Klajdi00/LibreRover/docs/Arduino-Robo-Workhop.pdf

Dennis Buchberger – 25.04.2026 | 1

## AKADEMIE DANACH 2026

# ROBOTERPROGRAMMIERUNG MIT ARDUINO

# WIR BAUEN EINEN ROBO

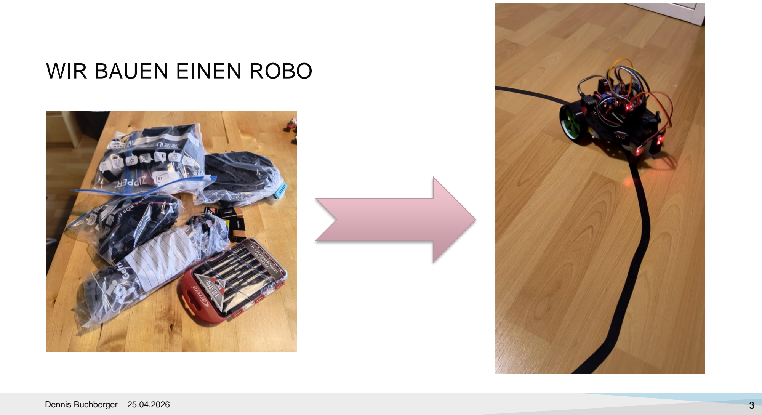
[picture p2: page 3]

# BAUTEILE: MIKROPROZESSOR

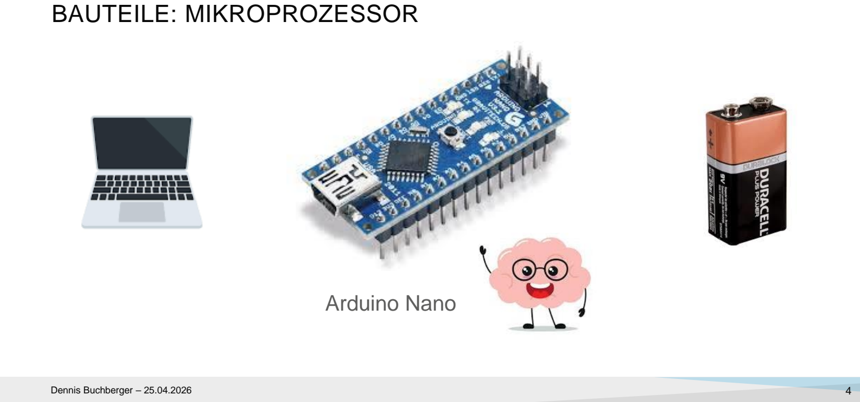
[picture p3: page 4]

# Arduino Nano

# BAUTEILE: SENSOREN

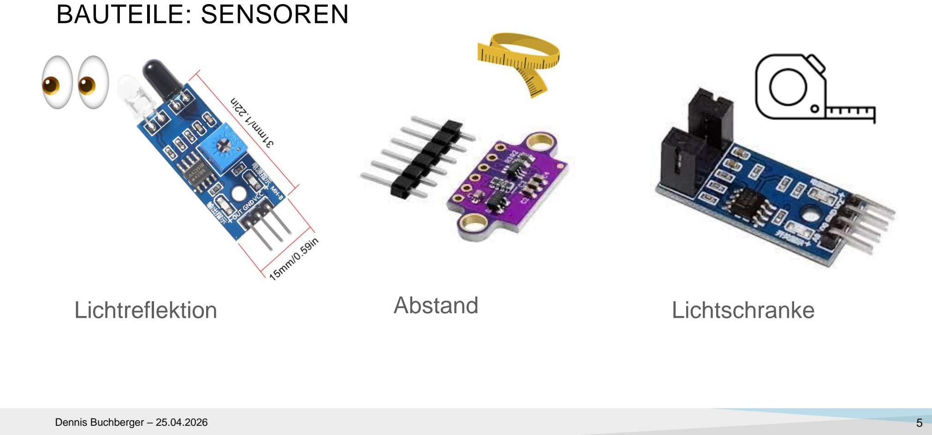
[picture p4: page 5]

Lichtreflektion | Abstand | Lichtschranke

# BAUTEILE: MOTOREN

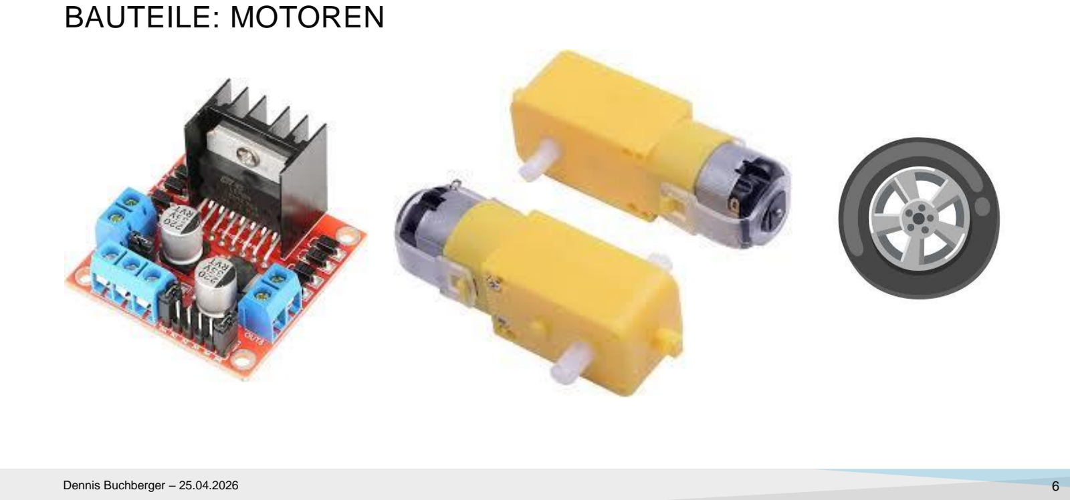
[picture p5: page 6]

# BREAKOUT-BOARD

# Pins

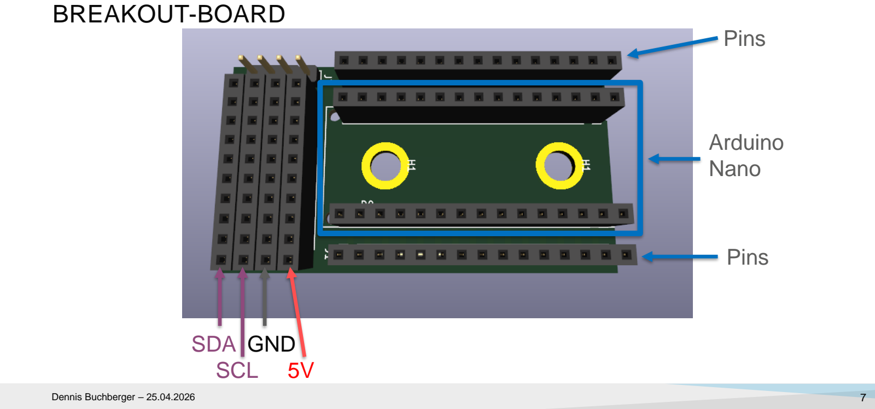
[picture p6: page 7]

# SDA GND SCL 5V

# Arduino Nano

# Pins

# WIE BEWEGT SICH DER MOTOR?

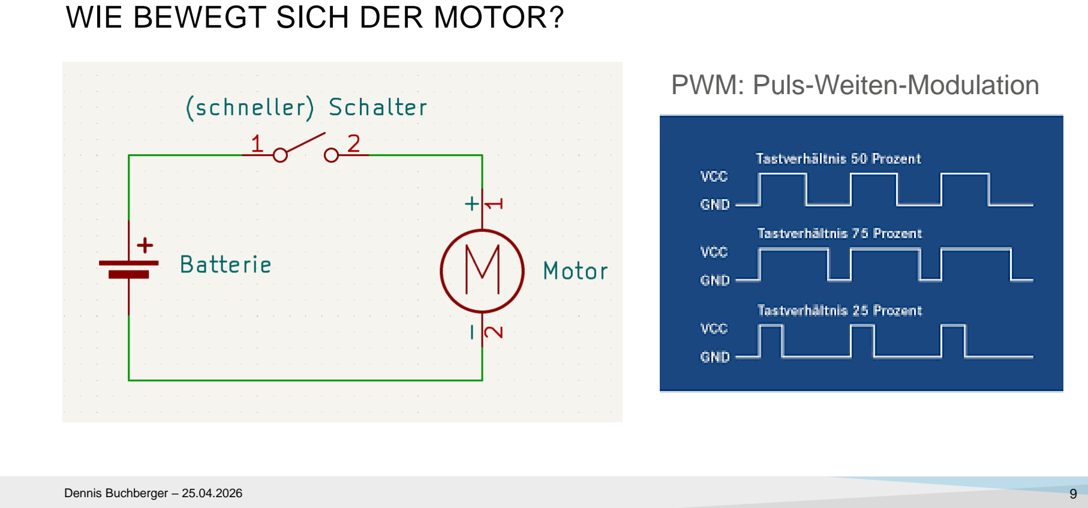
[picture p7: page 9]

# PWM: Puls-Weiten-Modulation

# MOTOR-TREIBER

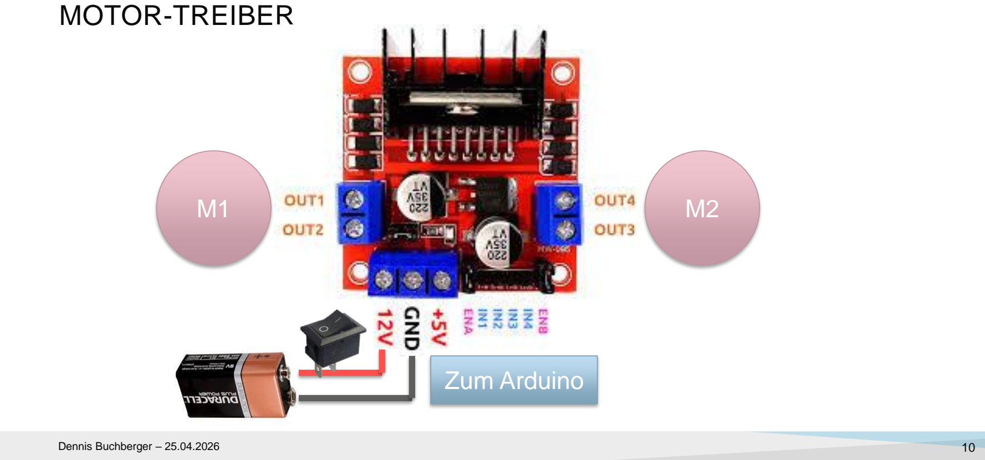
[picture p8: page 10]

M1 | M2

# Zum Arduino

# WIE FUNKTIONIEREN DIE LICHTSENSOREN?

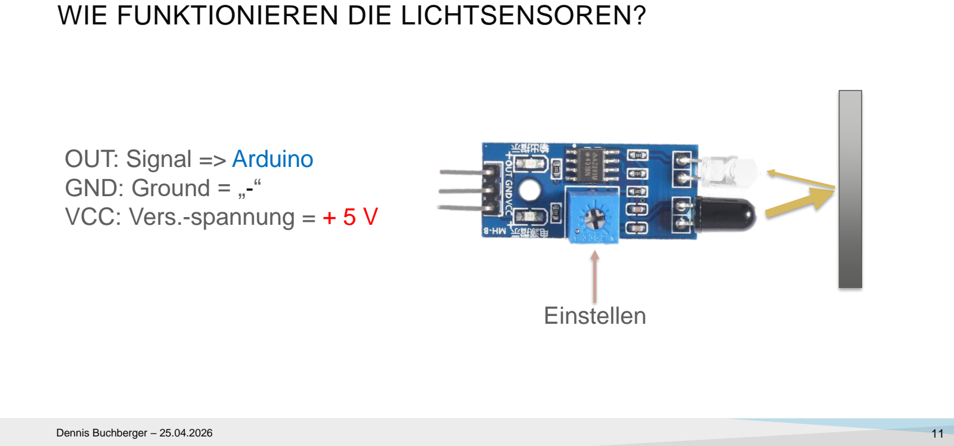
[picture p9: page 11]

# OUT: Signal => Arduino GND: Ground = „-“ VCC: Vers.-spannung = + 5 V

# Einstellen

# WIE FUNKTIONIEREN DIE ABSTANDSSENSOREN?

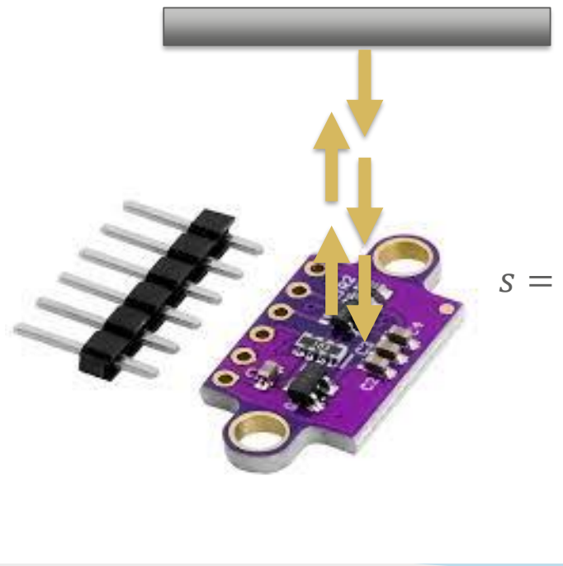
[picture p10: figure]

# GND: Ground = „-“ VCC: Vers.-spannung = + 5 V SCL: Serial Clock => I2C SDA: Serial Data => I2C XSHUT: Soft-Shutdown

Δt
c

I

# 2C: INTER-INTEGRATED-CIRCUIT BUS

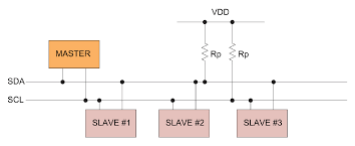
[picture p11: figure]

# Master: Steuert alles - Gibt Takt an (SCL) - Sendet Daten (SDA)

- Erlaubt den anderen,

# zu senden

# ARDUINO NANO: PINOUT

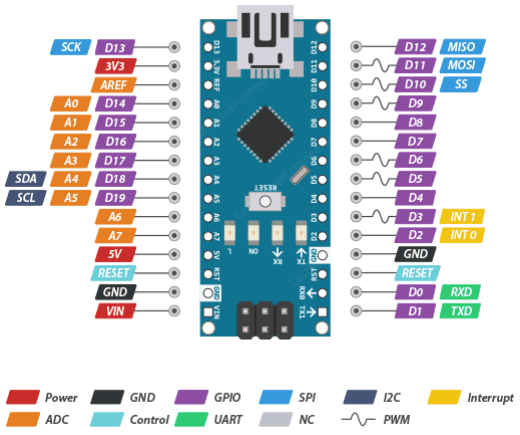
[picture p12: figure]
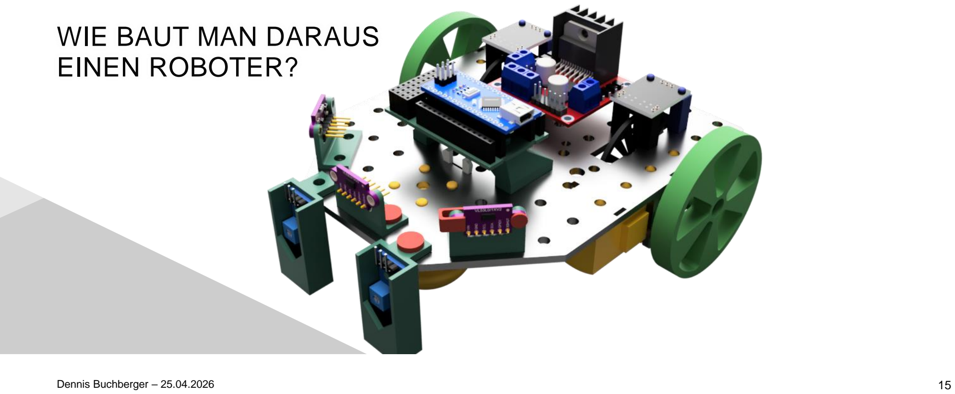
[picture p13: page 15]

# WIE BAUT MAN DARAUS EINEN ROBOTER?

# BODENPLATTE UND MOTOREN

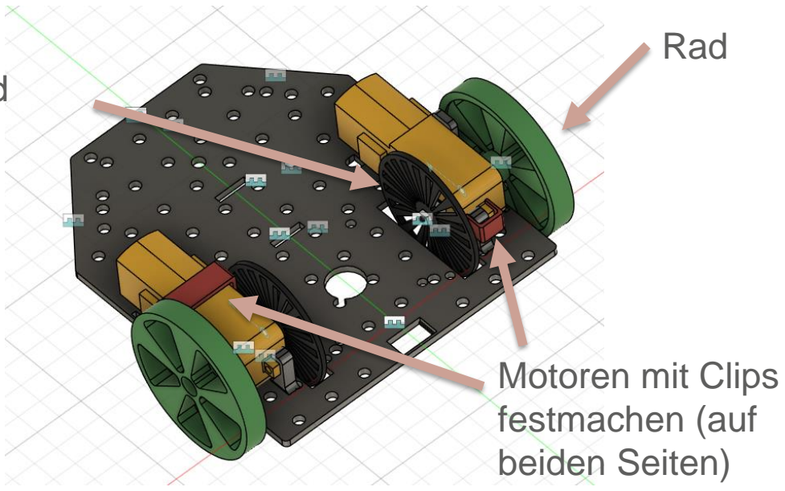
[picture p14: figure]
Motoren mit Clips festmachen (auf beiden Seiten); Rad

# Encoderrad (später)

# BATTERIE

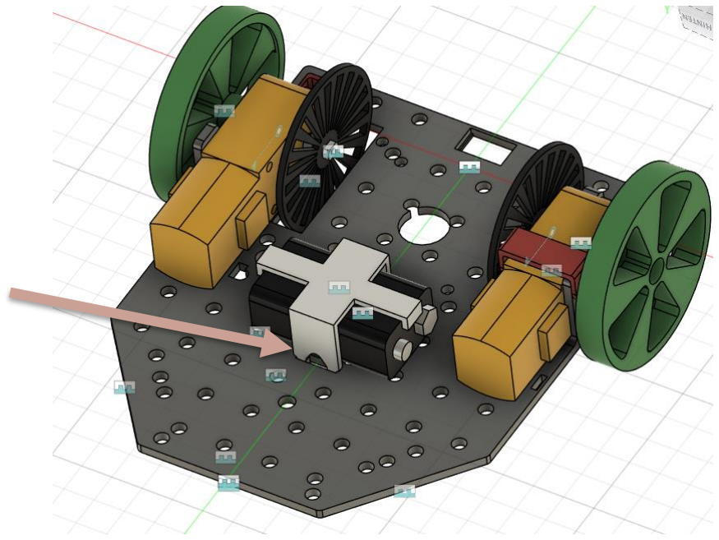
[picture p15: figure]

# Vorsichtig in die Schlitze drücken

# GLEITER („DRITTES RAD“)

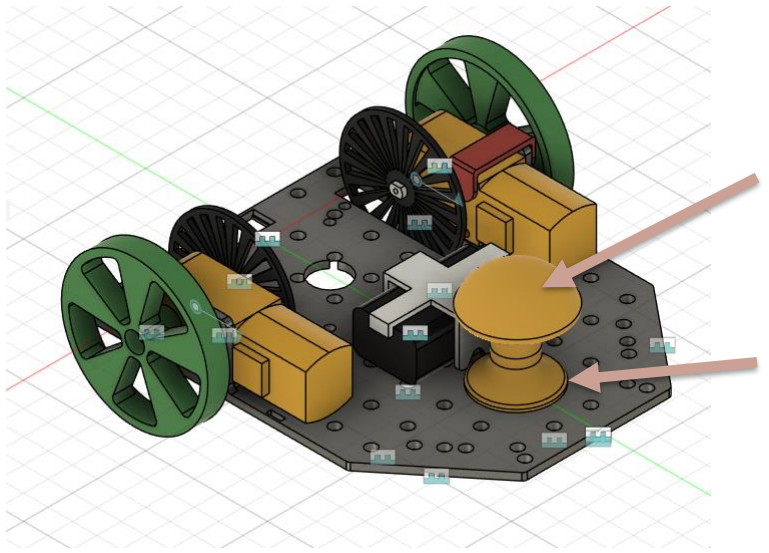
[picture p16: figure]

# Vorsichtig in die Löcher drücken

# Halben Tischtennisball darauf kleben

# MOTORTREIBER

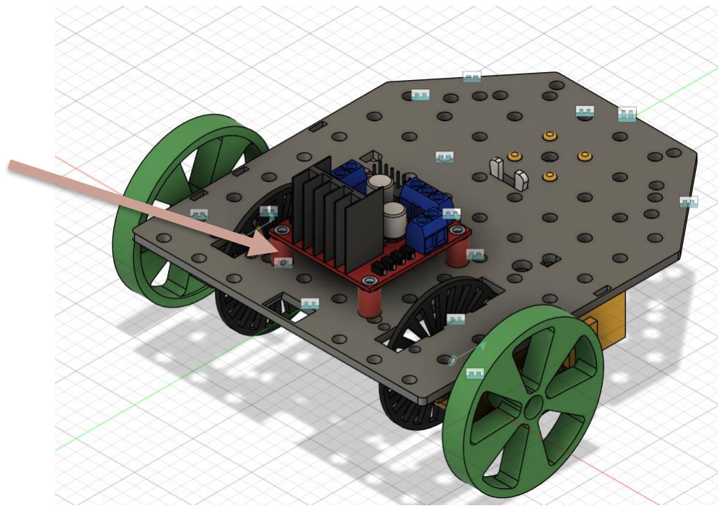
[picture p17: figure]

# Mit Abstandshaltern festschrauben

# ARDUINO

# Platine + Arduino Nano

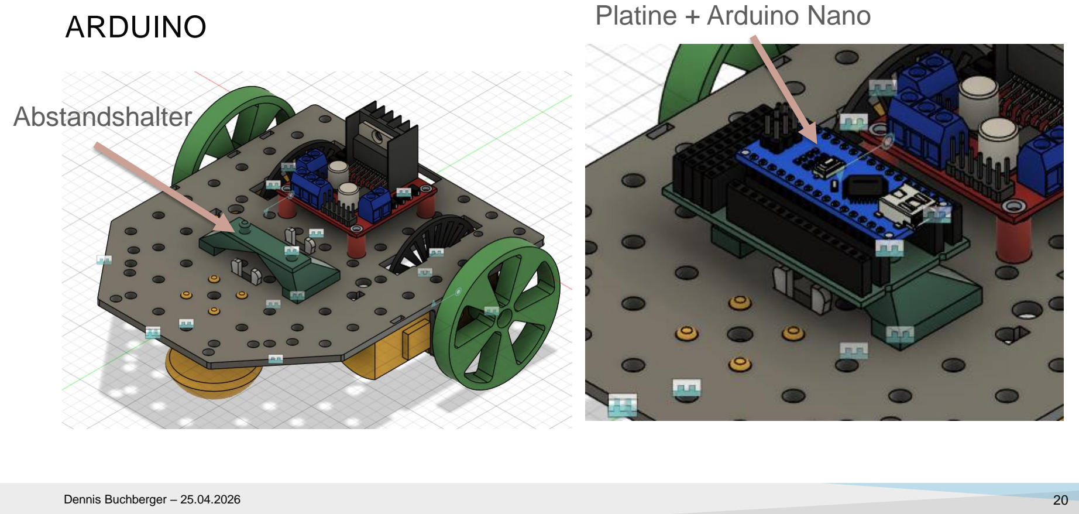
[picture p18: page 20]

# Abstandshalter

# LICHTSENSOREN

# Beide Sensoren mit Plastik-Pin vorsichtig festdrücken

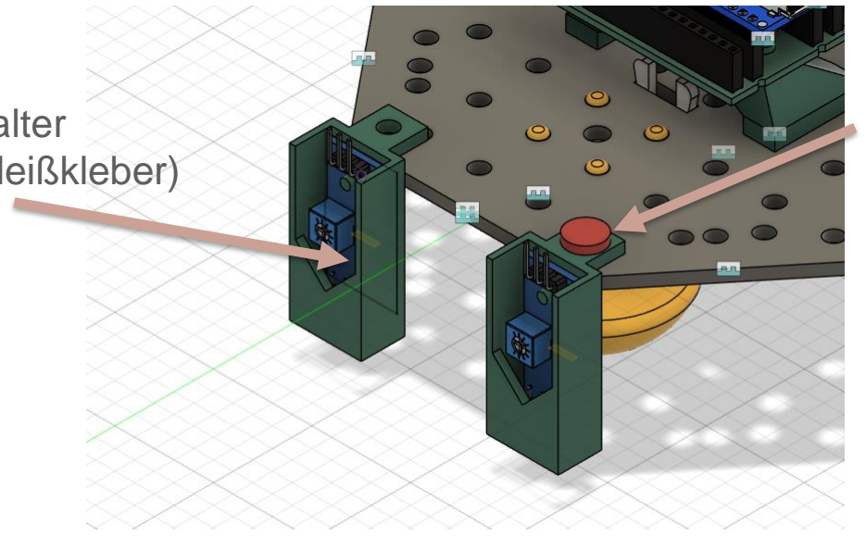
[picture p19: figure]

# Sensor in Halter einkleben (Heißkleber)

# MOTOR-ENCODER

# Vorsichtig

festdrücken,
eventuell kleben.

# Pfeilrichtung beachten

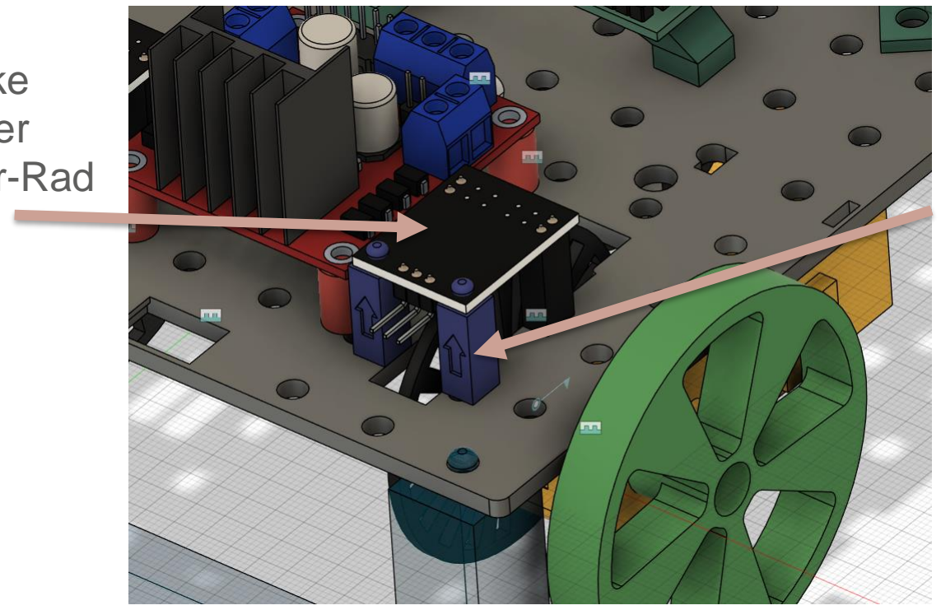
[picture p20: figure]

# Lichtschranke kopfüber über das Encoder-Rad

# ANSCHLÜSSE

# Motor-Treiber: - 12V: Schalter – Batterie

- 5V:

# - Arduino 5V - I2C 5V

# - GND: Alle GND zusammen - Motoren: Links und Rechts an „Out“

# - ENA => Arduino 11

# - 1, 2 => Arduino 9, 10 - 3, 4 => Arduino 7, 8

# - ENB => Arduino 6

# Reflektionssensor: - VCC => 5V (Vom I2C) - GND => GND (vom I2C)

# - Out => Arduino

# - Links: Pin 4

# - Rechts: Pin 5

# ANSCHLÜSSE

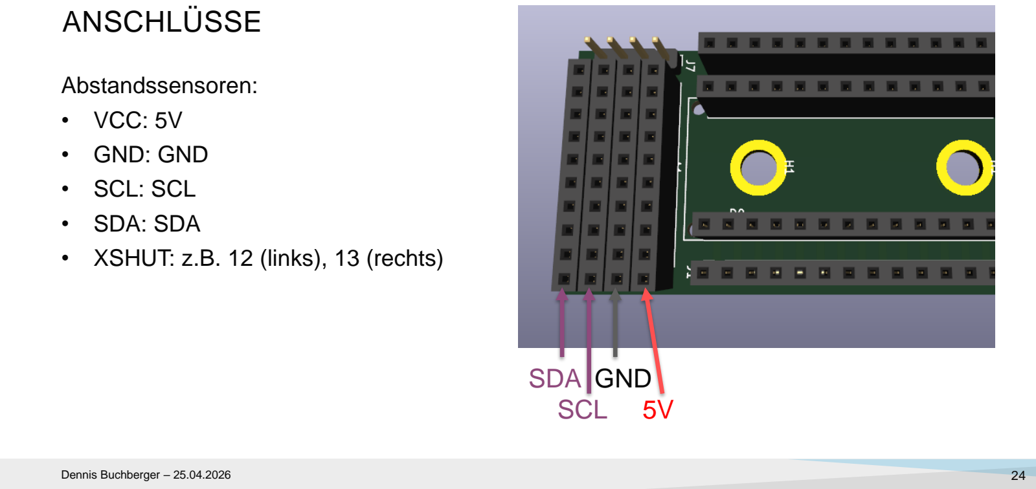
[picture p21: page 24]

# Abstandssensoren: - VCC: 5V - GND: GND

# - SCL: SCL

# - SDA: SDA

# - XSHUT: z.B. 12 (links), 13 (rechts)

# SDA GND SCL 5V

# ANSCHLÜSSE

# Motor-Encoder: - VCC: 5V - GND: GND

# - OUT: 3 (links), 2 (rechts)

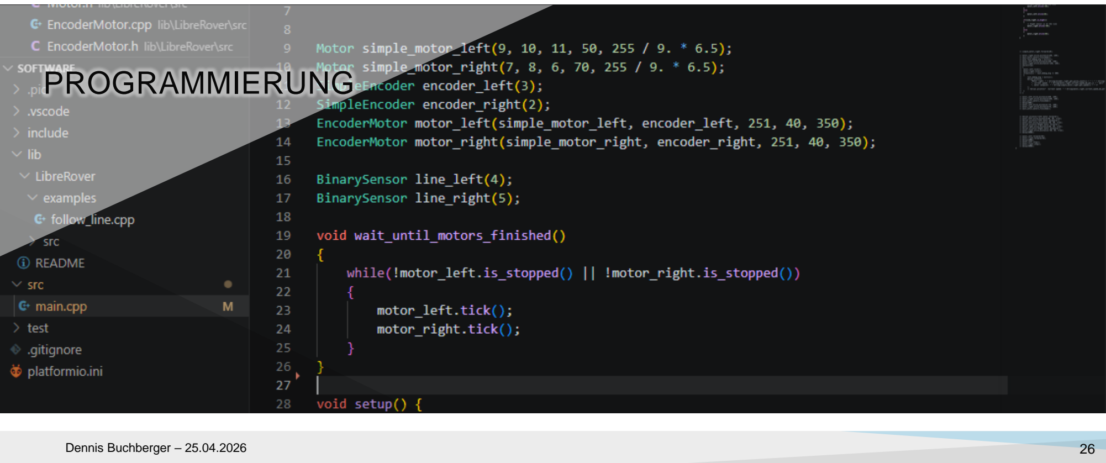
[picture p22: page 26]

# PROGRAMMIERUNG

# PROGRAMMIERUNG 1: FAHREN

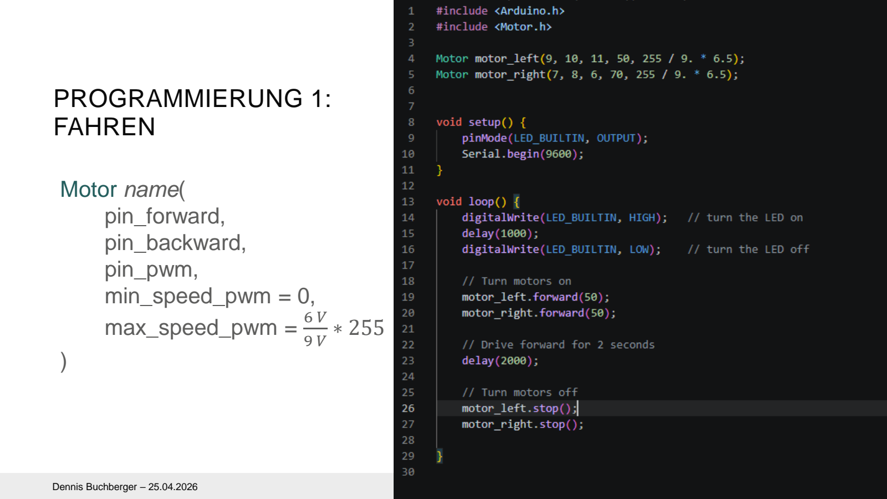
[picture p23: page 27]

Dennis Buchberger

– 25.04.2026 | 27

# Motor name

(

# pin_forward

,

# pin_backward

,

# pin_pwm

,
min_speed_pwm = 0,

# max_speed_pwm =

6

V
9

V

∗ 255
)

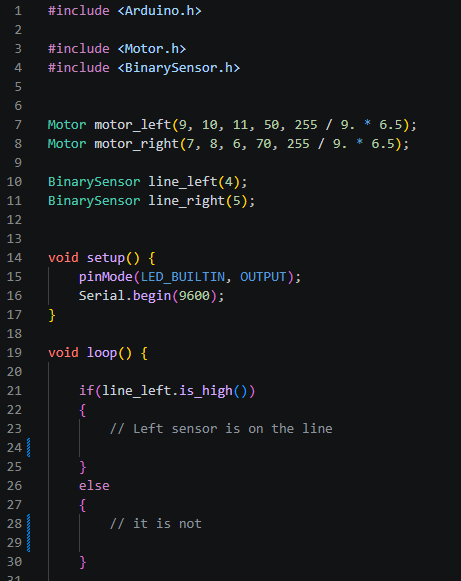
[picture p24: figure]

# PROGRAMMIERUNG 2: SENSOREN

# BinarySensor name( pin

);

## HTTPS://GITHUB.COM/BUCHBERGERD/LIBREROVER

# DANKE!
