Klajdi00/LibreRover/hardware/mechanical/Stand_Back.step

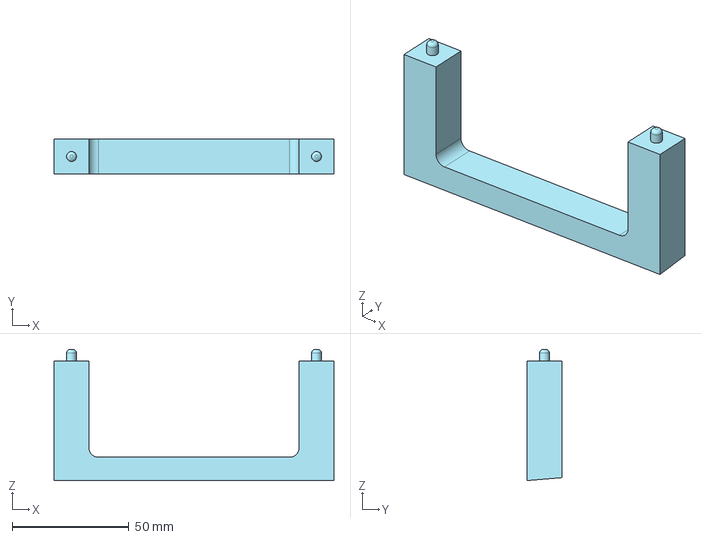
[picture p25: CAD file, 2026-05-05]
hardware/mechanical/Stand_Back.step
120.0 x 15.0 x 56.2 mm
