Klajdi00/LibreRover/hardware/pcb/Arduino_Nano_Breakout/Arduino_Nano_Breakout.step

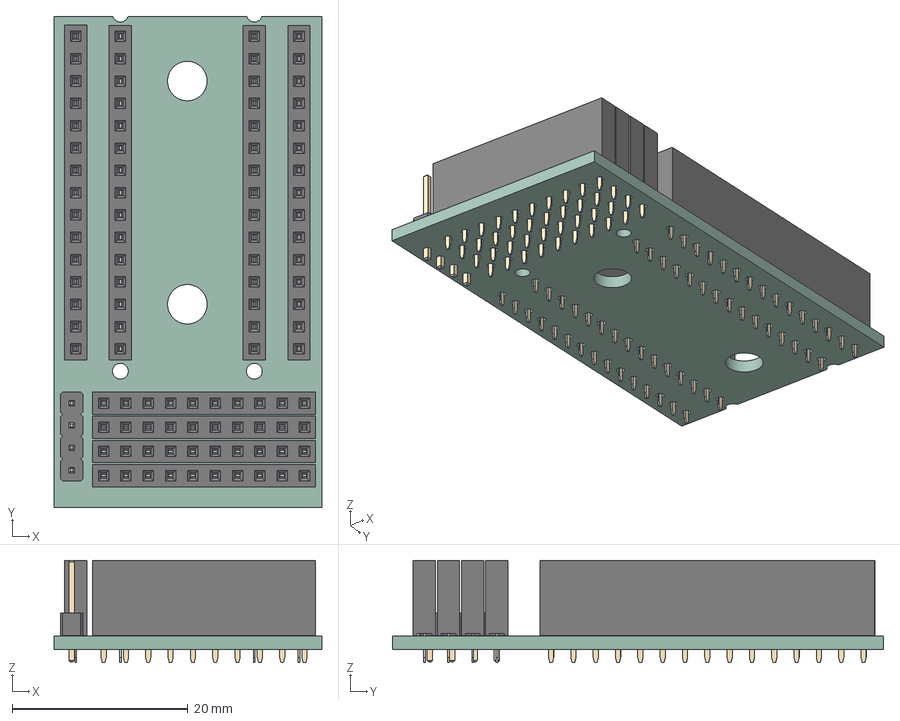
[picture p26: CAD file, 2026-02-21]
hardware/pcb/Arduino_Nano_Breakout/Arduino_Nano_Breakout.step
30.5 x 55.9 x 11.6 mm
PinSocket_1x10_P2.54mm_Vertical x 4
PinSocket_1x15_P2.54mm_Vertical x 4
PinHeader_1x04_P2.54mm_Vertical
Arduino_Nano_Breakout_PCB
