Klajdi00/LibreRover/hardware/mechanical/Encoder_Wheel_60.step

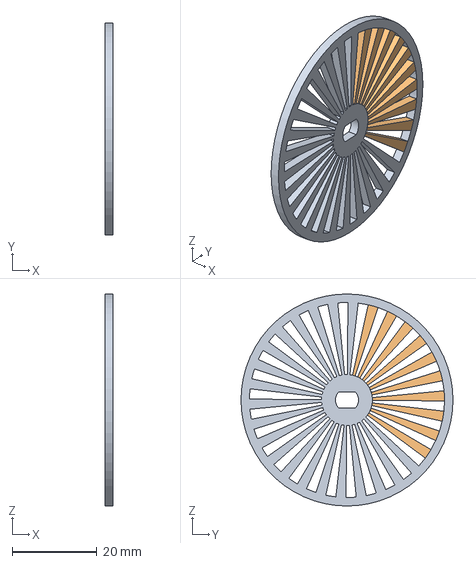
[picture p27: CAD file, 2026-04-08]
hardware/mechanical/Encoder_Wheel_60.step
2.00 x 50.0 x 50.0 mm
