Klajdi00/LibreRover/hardware/mechanical/Base.step

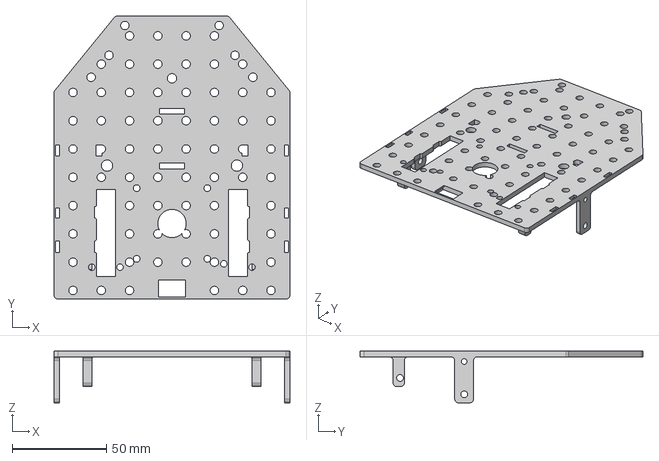
[picture p28: CAD file, 2026-04-08]
hardware/mechanical/Base.step
125.2 x 150.0 x 27.4 mm
