Klajdi00/LibreRover/hardware/mechanical/Simple_pin.step

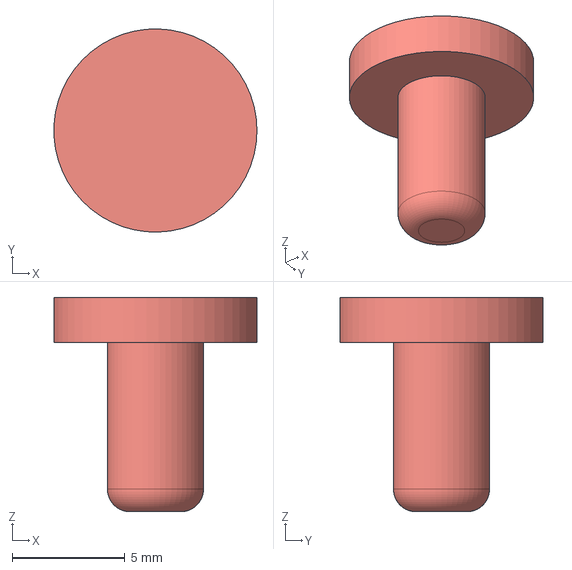
[picture p29: CAD file, 2026-02-21]
hardware/mechanical/Simple_pin.step
8.99 x 9.00 x 9.50 mm
