Klajdi00/LibreRover/hardware/mechanical/Pin_VL53L0X.step

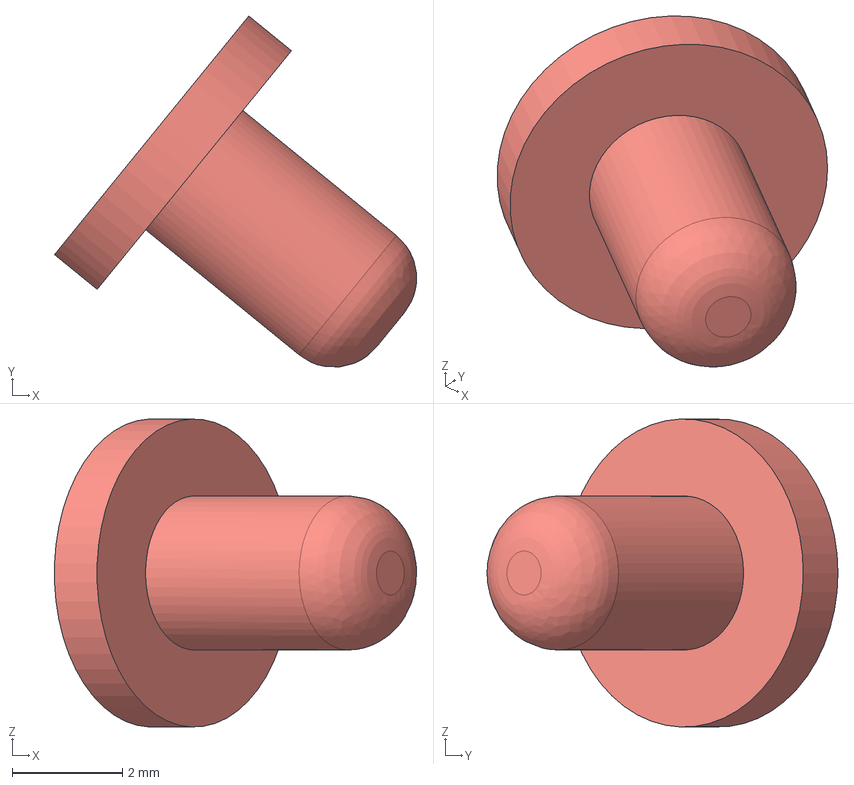
[picture p30: CAD file, 2026-02-21]
hardware/mechanical/Pin_VL53L0X.step
6.58 x 6.38 x 5.60 mm
