Klajdi00/LibreRover/hardware/mechanical/Mount_Arduino_Breakout.step

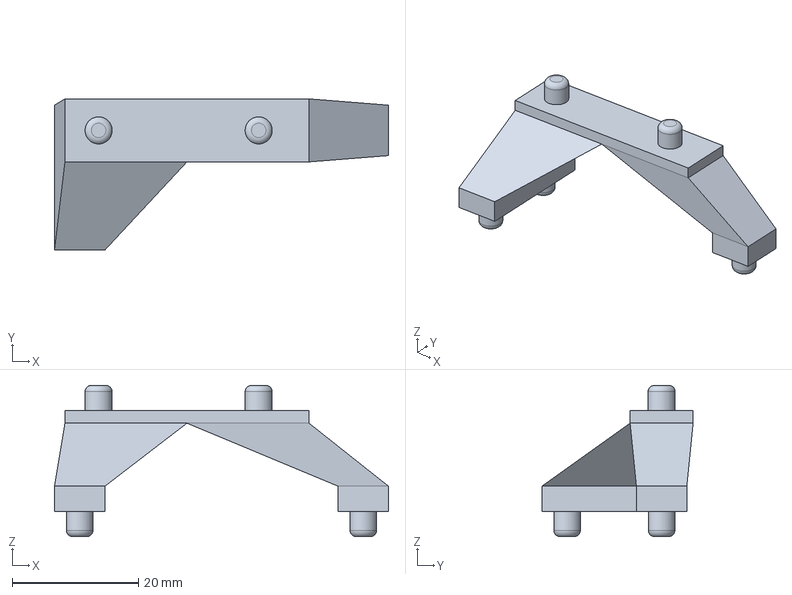
[picture p31: CAD file, 2026-02-21]
hardware/mechanical/Mount_Arduino_Breakout.step
53.0 x 24.0 x 24.0 mm
