Klajdi00/LibreRover/hardware/mechanical/Pin_Motor.step

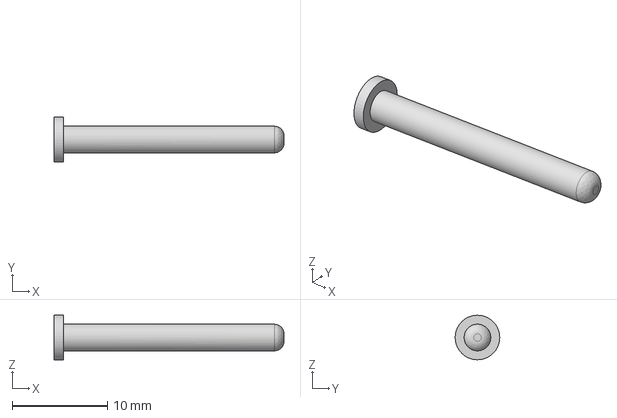
[picture p32: CAD file, 2026-02-21]
hardware/mechanical/Pin_Motor.step
24.2 x 4.68 x 4.68 mm
