Klajdi00/LibreRover/hardware/mechanical/Clamp_VL53L0X.step

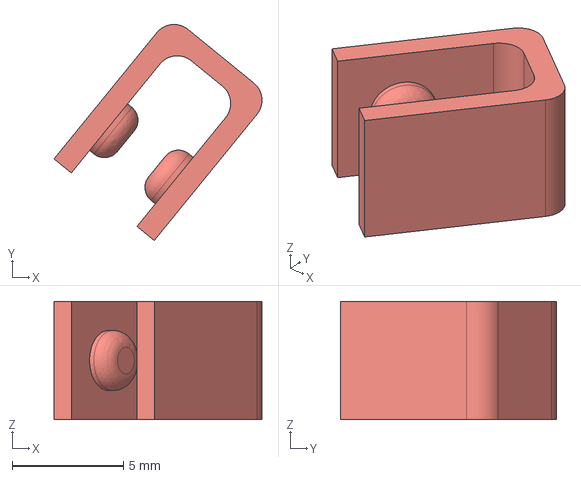
[picture p33: CAD file, 2026-02-21]
hardware/mechanical/Clamp_VL53L0X.step
9.33 x 9.69 x 5.30 mm
