Klajdi00/LibreRover/hardware/mechanical/Mount_VL53L0X.step

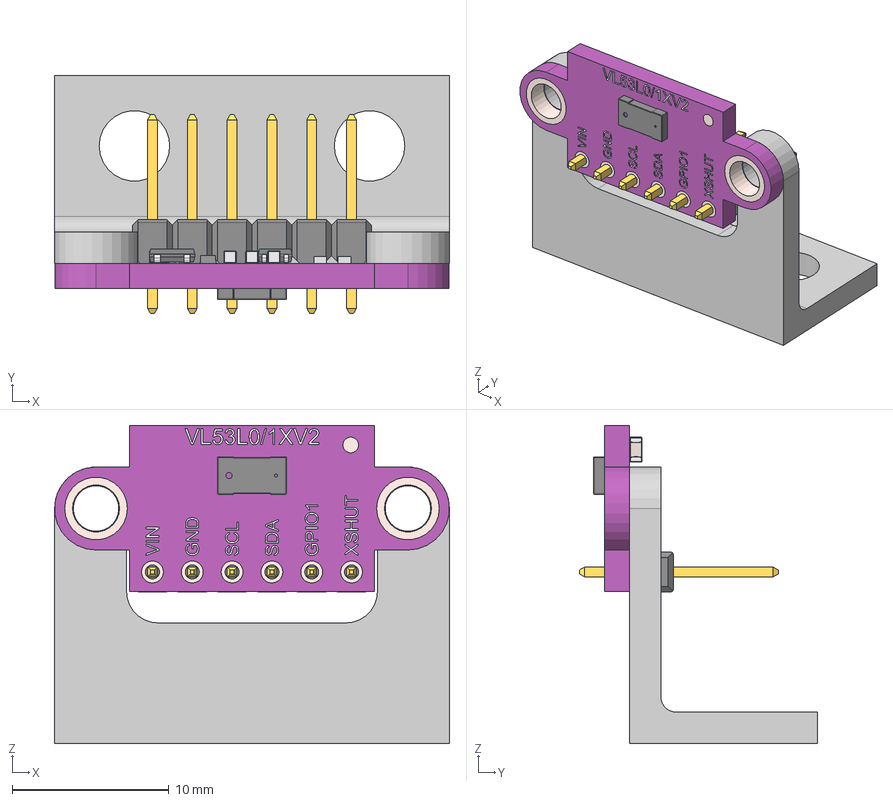
[picture p34: CAD file, 2026-02-21]
hardware/mechanical/Mount_VL53L0X.step
25.2 x 15.2 x 20.3 mm
top
pcb
kork
pads
Document
Document_1
Pin1
Pin2
CeramicBody
Pin1_1
Pin2_1
CeramicBody_1
Pin1_2
Pin2_2
CeramicBody_2
Pin1_3
Pin2_3
CeramicBody_3
SOT-23-3 v1
SOT-23-6 v2
8_Pin_DIP
1x6 TH Pitch 2.54mm v1
