Klajdi00/LibreRover/hardware/mechanical/Glider.step

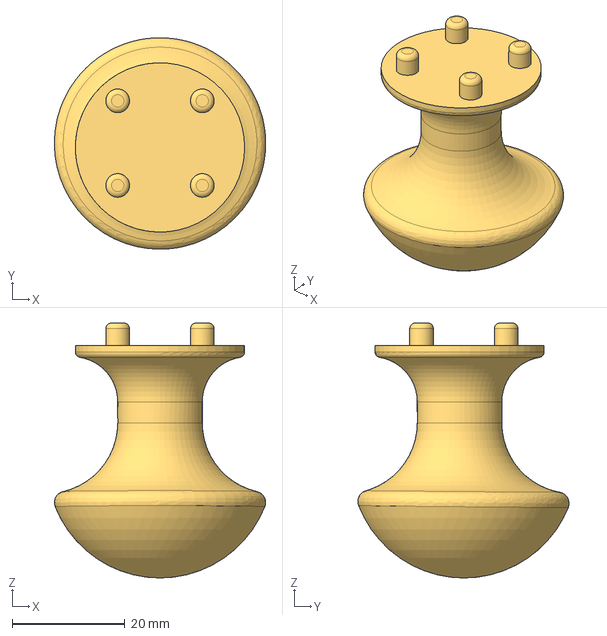
[picture p35: CAD file, 2026-02-21]
hardware/mechanical/Glider.step
37.5 x 37.5 x 45.2 mm
