Klajdi00/LibreRover/hardware/mechanical/Clamp_Motor_Nose.step

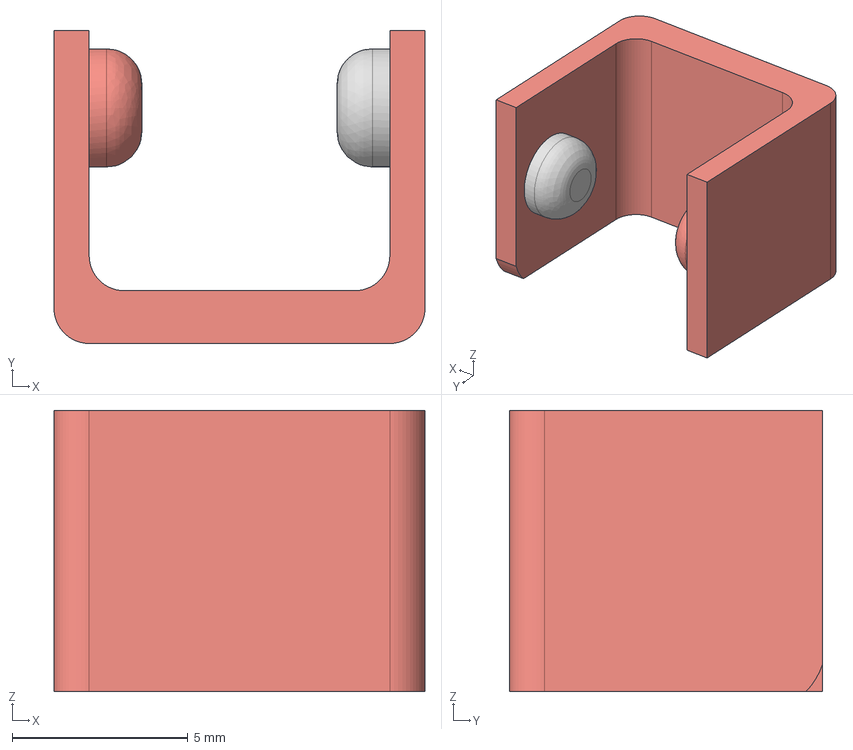
[picture p36: CAD file, 2026-02-21]
hardware/mechanical/Clamp_Motor_Nose.step
10.5 x 8.90 x 8.00 mm
