Klajdi00/LibreRover/hardware/mechanical/Mount_HW-201.step

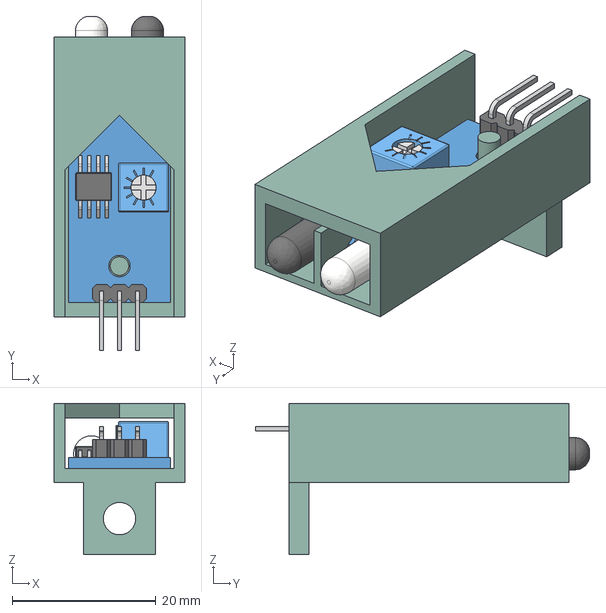
[picture p37: CAD file, 2026-02-21]
hardware/mechanical/Mount_HW-201.step
18.2 x 46.6 x 21.0 mm
HW-201 v4
Halter
