Klajdi00/LibreRover/hardware/mechanical/Mount_Encoder.step

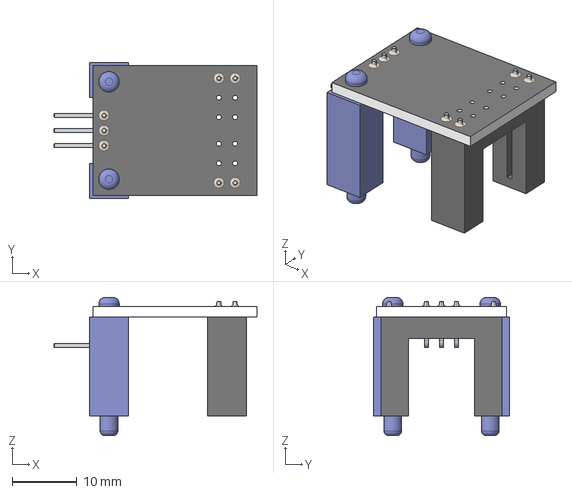
[picture p38: CAD file, 2026-02-21]
hardware/mechanical/Mount_Encoder.step
31.3 x 21.0 x 21.3 mm
Halter
ir encoder motor speed
