Klajdi00/LibreRover/hardware/mechanical/Wheel.step

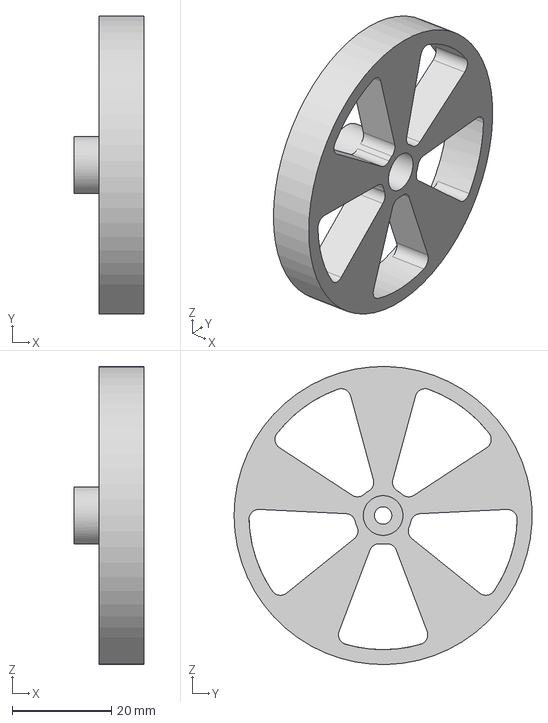
[picture p39: CAD file, 2026-02-21]
hardware/mechanical/Wheel.step
14.0 x 60.0 x 60.0 mm
