Klajdi00/LibreRover/hardware/mechanical/9V_Block_Mounting.step

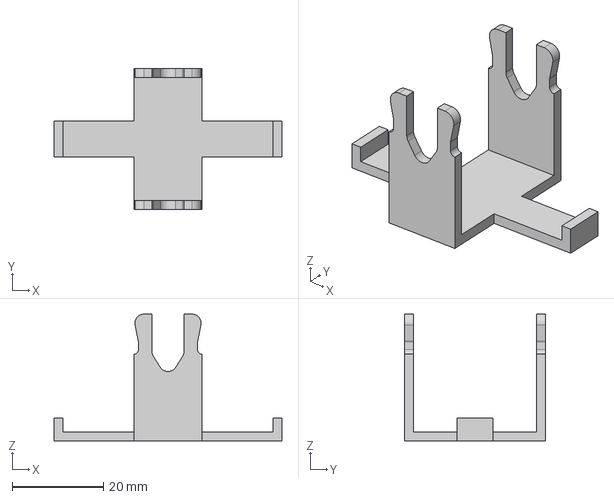
[picture p40: CAD file, 2026-02-21]
hardware/mechanical/9V_Block_Mounting.step
50.0 x 31.0 x 27.8 mm
