Klajdi00/LibreRover/hardware/mechanical/Encoder_Wheel_40.step

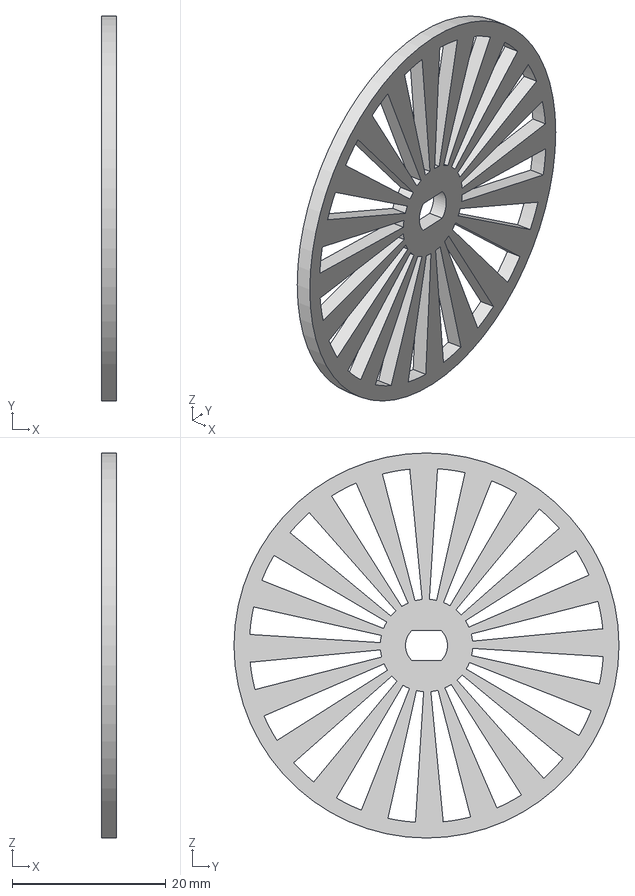
[picture p41: CAD file, 2026-02-21]
hardware/mechanical/Encoder_Wheel_40.step
2.00 x 50.0 x 50.0 mm
