Klajdi00/LibreRover/hardware/mechanical/Clamp_Motor_Body.step

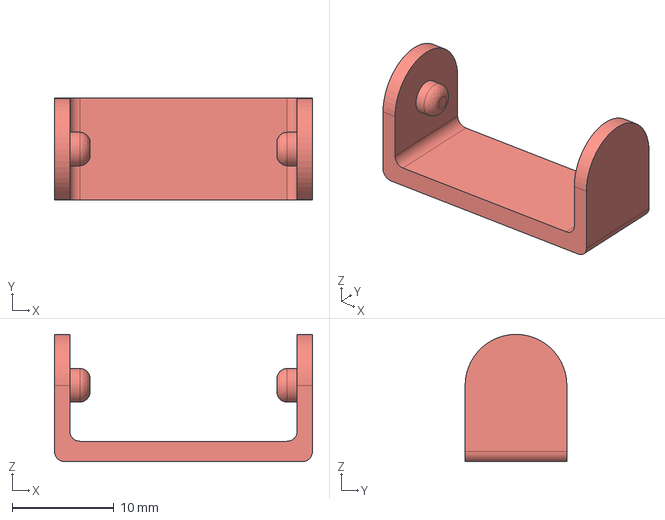
[picture p42: CAD file, 2026-02-21]
hardware/mechanical/Clamp_Motor_Body.step
25.4 x 10.0 x 12.5 mm
