Klajdi00/LibreRover/(list of files, cad)

Other CAD files:
hardware/mechanical/Rover.f3z
