Klajdi00/LibreRover/hardware/pcb/Arduino_Nano_Breakout/Arduino_Nano_Breakout.kicad_pcb

## KiCad design hardware/pcb/Arduino_Nano_Breakout/Arduino_Nano_Breakout.kicad_pcb (2026-02-21)

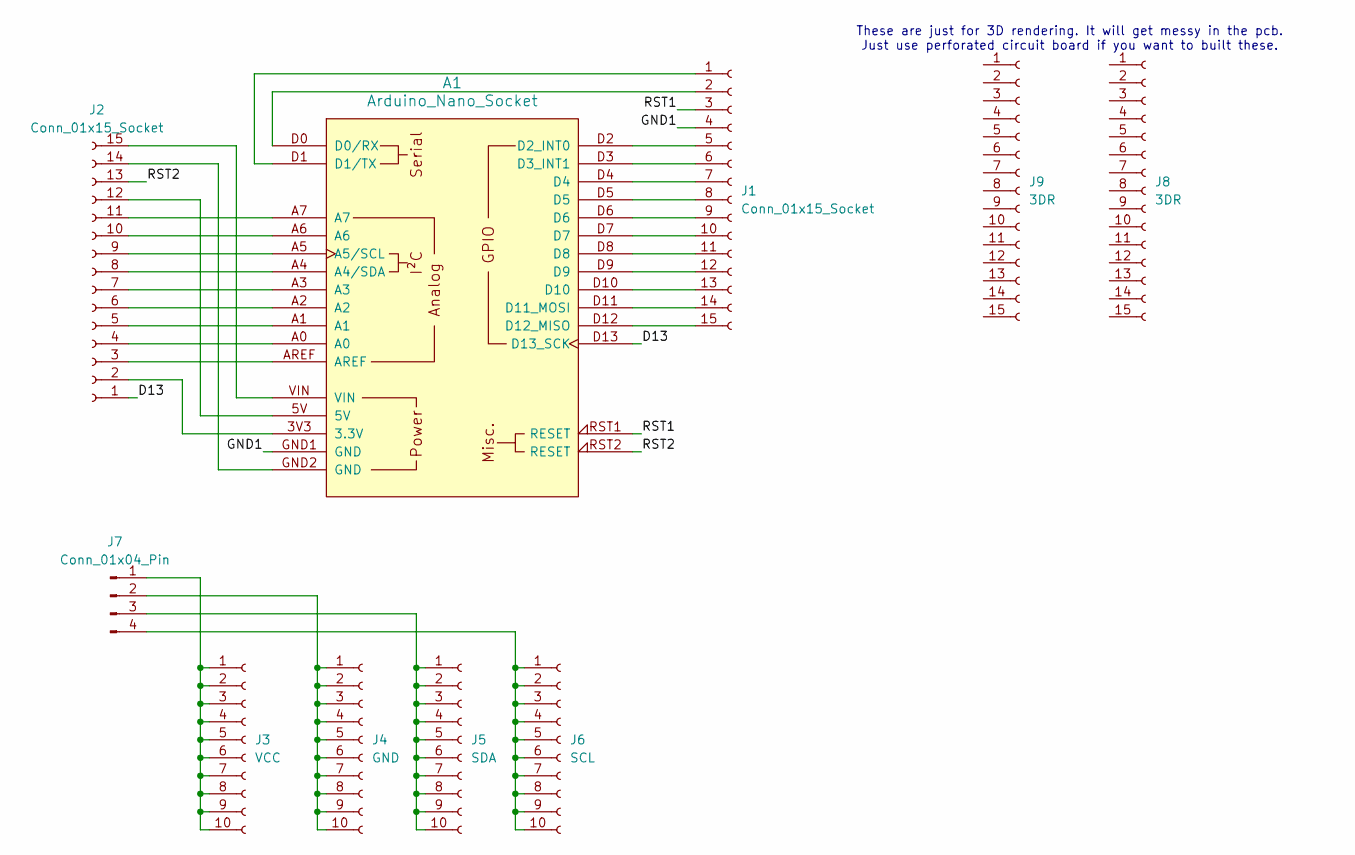
[picture p43: schematic Arduino_Nano_Breakout.kicad_sch]

Parts:
A1: Arduino_Nano_Socket
J1, J2: Conn_01x15_Socket; PinSocket_1x15_P2.54mm_Vertical
J3: VCC; PinSocket_1x10_P2.54mm_Vertical
J4: GND; PinSocket_1x10_P2.54mm_Vertical
J5: SDA; PinSocket_1x10_P2.54mm_Vertical
J6: SCL; PinSocket_1x10_P2.54mm_Vertical
J7: Conn_01x04_Pin; PinHeader_1x04_P2.54mm_Vertical
J8, J9: 3DR; PinSocket_1x15_P2.54mm_Vertical

Connections:
/D13: A1.D13 (D13_SCK), J2.1
/GND1: A1.GND1 (GND), J1.4
/RST1: A1.RST1 (RESET), J1.3
/RST2: A1.RST2 (RESET), J2.13
unnamed: A1.3V3 (3.3V), J2.2
unnamed: A1.A4 (A4/SDA), J2.8
unnamed: A1.A5 (A5/SCL), J2.9
unnamed: A1.D0 (D0/RX), J1.2
unnamed: A1.D1 (D1/TX), J1.1
unnamed: A1.D2 (D2_INT0), J1.5
unnamed: A1.D3 (D3_INT1), J1.6
unnamed: A1.D11 (D11_MOSI), J1.14
unnamed: A1.D12 (D12_MISO), J1.15
unnamed: A1.D4, J1.7
unnamed: A1.D5, J1.8
unnamed: A1.D6, J1.9
unnamed: A1.D7, J1.10
unnamed: A1.D8, J1.11
unnamed: A1.D9, J1.12
unnamed: A1.D10, J1.13
unnamed: A1.AREF, J2.3
unnamed: A1.A0, J2.4
unnamed: A1.A1, J2.5
unnamed: A1.A2, J2.6
unnamed: A1.A3, J2.7
unnamed: A1.A6, J2.10
unnamed: A1.A7, J2.11
unnamed: A1.5V, J2.12
unnamed: A1.GND2 (GND), J2.14
unnamed: A1.VIN, J2.15
unnamed: J3.1, J3.2, J3.3, J3.4, J3.5, J3.6, J3.7, J3.8, J3.9, J3.10, J7.1
unnamed: J4.1, J4.2, J4.3, J4.4, J4.5, J4.6, J4.7, J4.8, J4.9, J4.10, J7.2
unnamed: J5.1, J5.2, J5.3, J5.4, J5.5, J5.6, J5.7, J5.8, J5.9, J5.10, J7.3
unnamed: J6.1, J6.2, J6.3, J6.4, J6.5, J6.6, J6.7, J6.8, J6.9, J6.10, J7.4

Notes on the sheet:
These are just for 3D rendering. It will get messy in the pcb. Just use perforated circuit board if you want to built these.

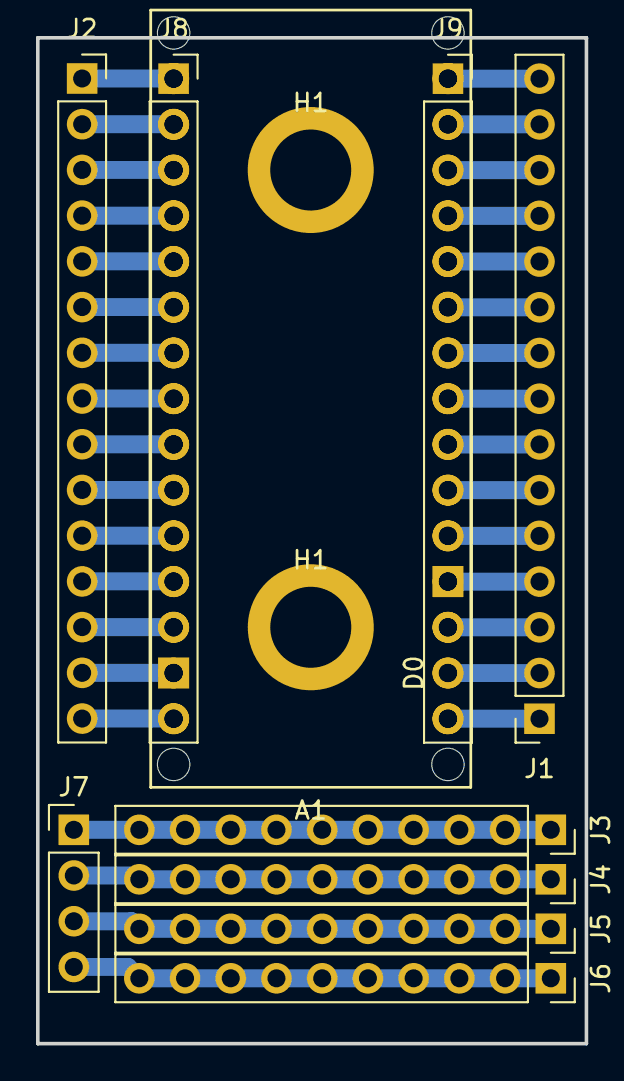
[picture p44: board Arduino_Nano_Breakout.kicad_pcb from above]

Board: 2 copper layers, 30.5 x 55.9 mm, 12 parts (0 on the bottom side), 34 nets.

Other parts of the board:
H1, H1#2: M4; MountingHole_3.2mm_M3_DIN965_Pad
