Klajdi00/LibreRover/(commit log)

2026-02-21 Added KiCad project for a simple Arduino Nano breakout board. Used for the 3D design; for building, just use a breadboard
    [Arduino_Nano_Breakout.kicad_pcb, Arduino_Nano_Breakout.kicad_sch, Arduino_Nano_Breakout.step]
2026-04-08 Fixed bug in mechanical base. Added Encoder Wheel with higher resolution.
    [Base.step, Encoder_Wheel_60.step]
2026-05-05 Added VL53L0X distance sensor. Added workshop tutorial.
    [Stand_Back.step]
